rakdabhi/Treat-Following-Dog-Robot/Motor Diagram.jpg

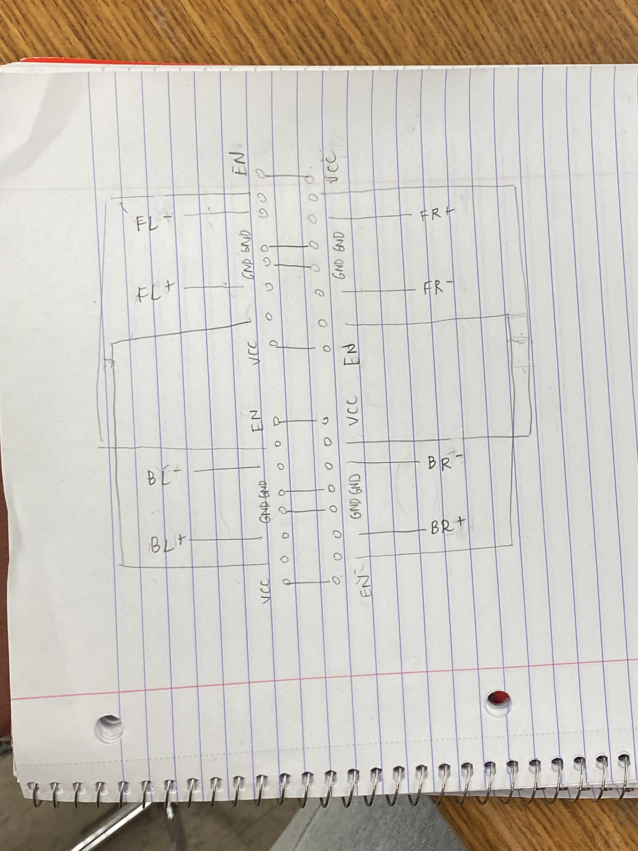
Motor Diagram.jpg
