rakdabhi/Treat-Following-Dog-Robot/README.md

## Demo Video
https://youtu.be/8WpnZkCvqOY
