rakdabhi/Treat-Following-Dog-Robot/3D Printing Files/Dog Head.stl

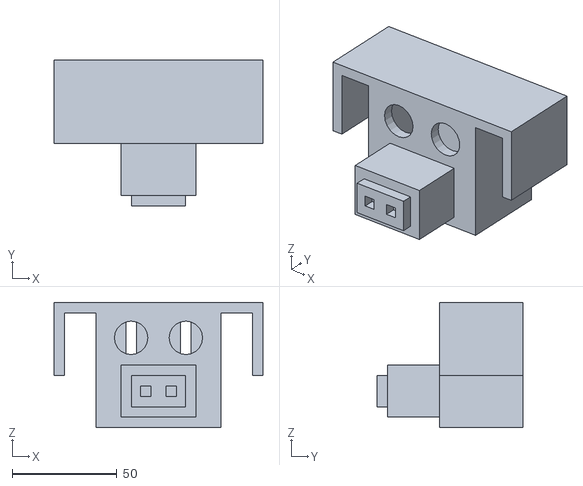
[picture p5: CAD file, 2024-02-24]
3D Printing Files/Dog Head.stl
100.0 x 70.0 x 60.0
