rakdabhi/Treat-Following-Dog-Robot/3D Printing Files/Bone.stl

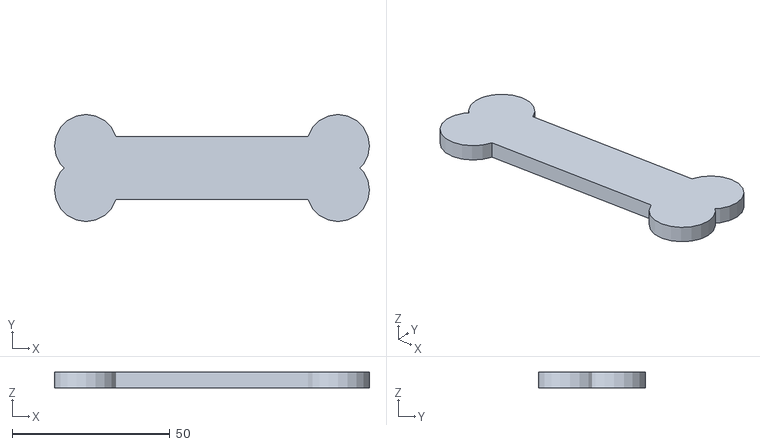
[picture p6: CAD file, 2024-02-24]
3D Printing Files/Bone.stl
100.0 x 34.0 x 5.00
