rakdabhi/Treat-Following-Dog-Robot/(commit log)

2024-02-24 SVG file for laser-cutting the chassis of the robot dog
2024-02-24 3D files for printing the Head and Bone
    [Rahul Aggarwal 3D Printing File.stl, Rakshit Dabhi 3D Printing File.stl]
2024-02-24 Pictures of Circuitry and End Product
2024-02-24 Added 3D Printing Files
    [Bone.stl, Dog Head.stl]
2024-02-24 Added Laser Cut Files
2024-02-24 Added Pictures Showing Internal Circuitry
